NikonPic/full_motor/esc/esc.pdf

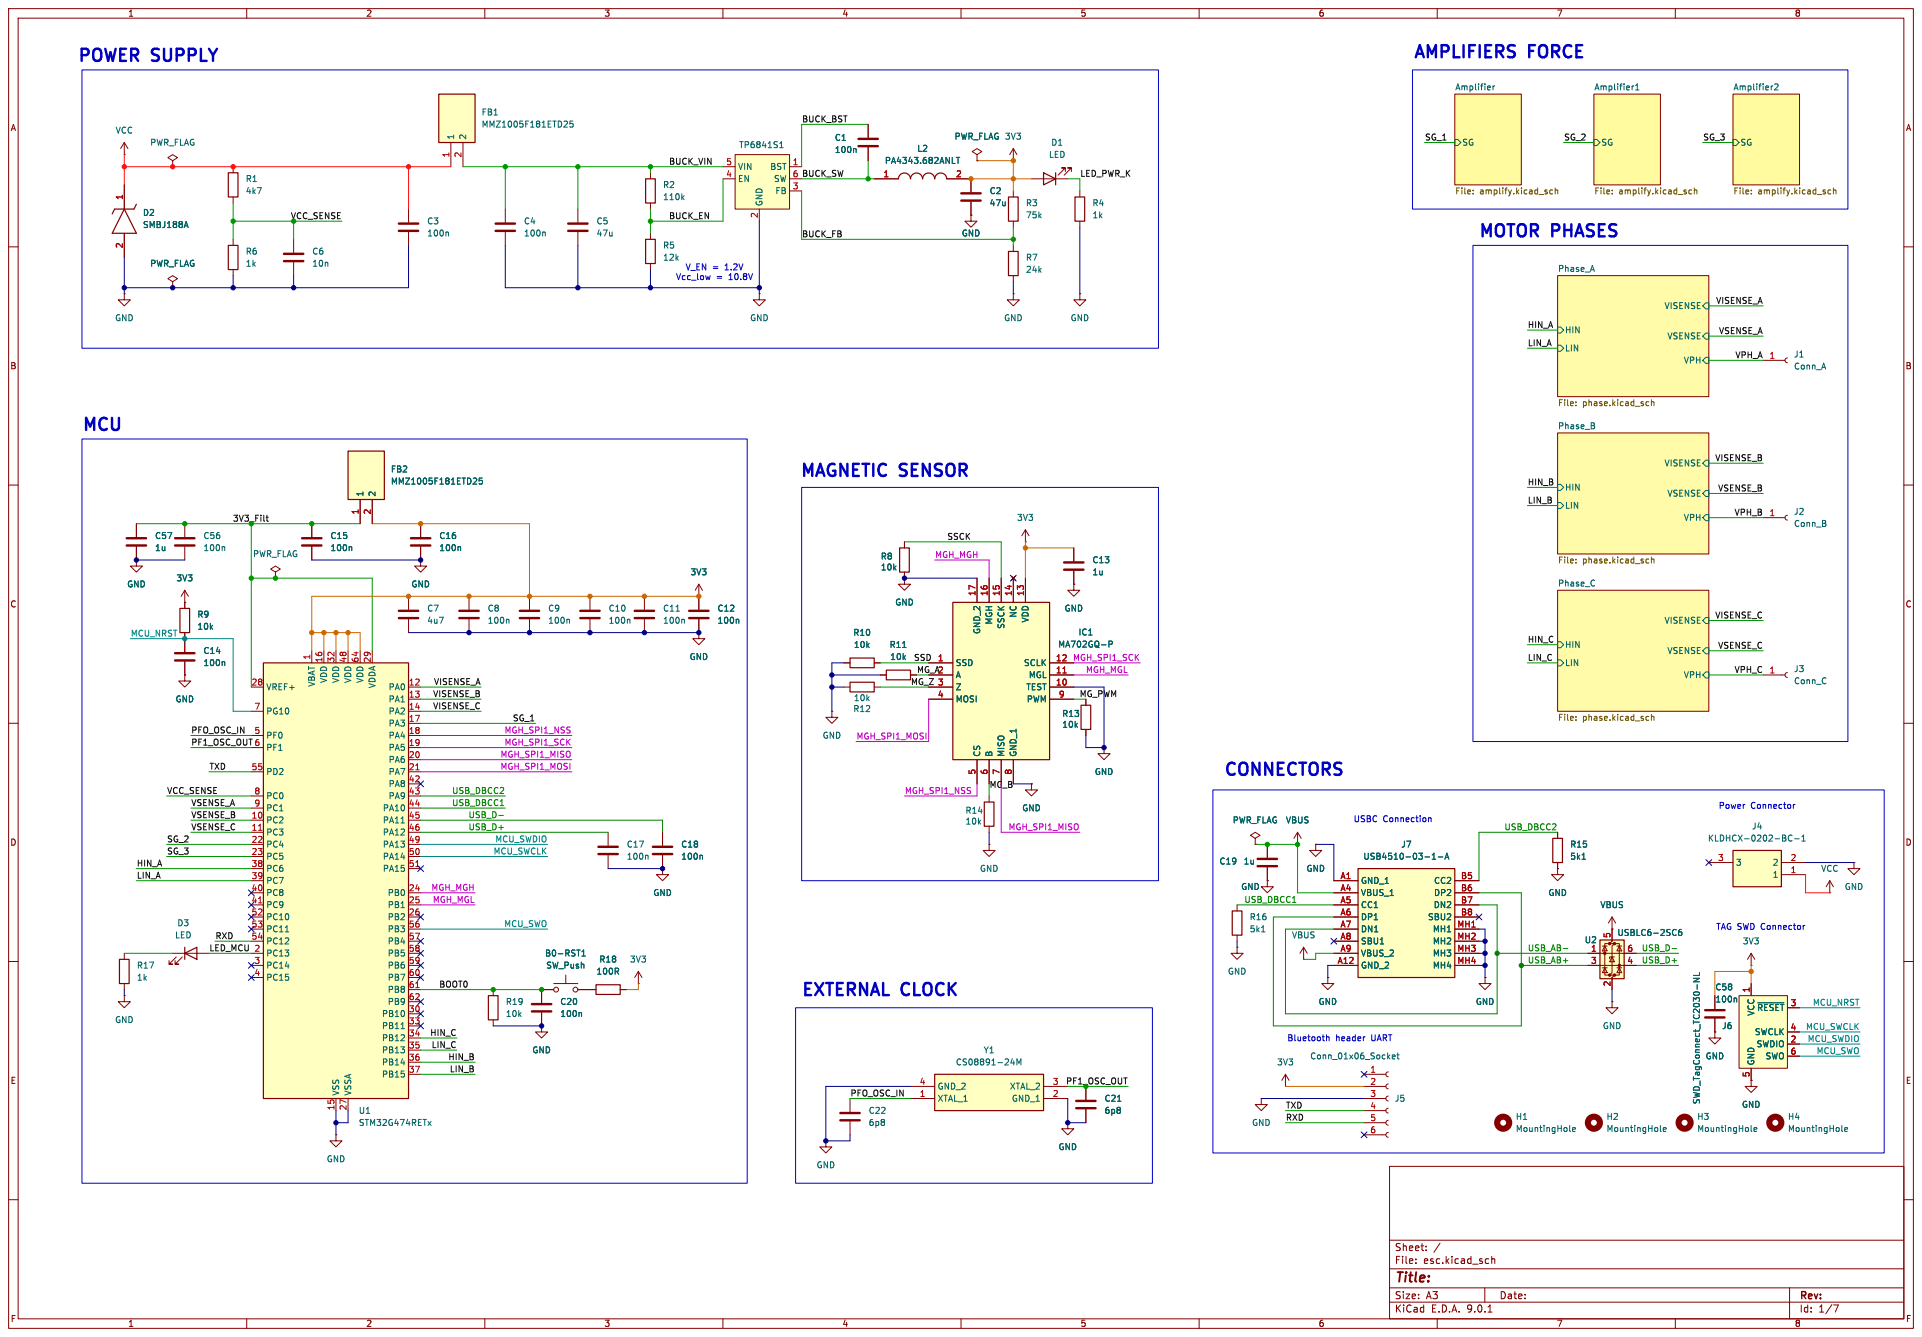
[picture p1: page 1]

8 VDD 13 SCLK 12 MGL 11 TEST 10 PWM 9

8 VDD 13 SCLK 12 MGL 11 TEST 10 PWM 9GND

1 VDD 16 VDD 32 VSS 15 VDD 48 VSSA 27 VDD 64 VDDA 29 PA0 12 PA1 13 PA2 14 PA3 17 PA4 18 PA5 19 PA6 20 PA7 21 PA8 42 PA9 43 PA10 44 PA11 45 PA12 46 PA13 49 PA14 50 PA15 51 PB0 24 PB1 25 PB2 26 PB3 56 PB4 57 PB5 58 PB6 59 PB7 60 PB8 61 PB9 62 PB10 30 PB11 33 PB12 34 PB13 35 PB14 36 PB15 37 U1STM32G474RETx GND

Id: 1/7 Title: File: esc.kicad_sch Sheet: /

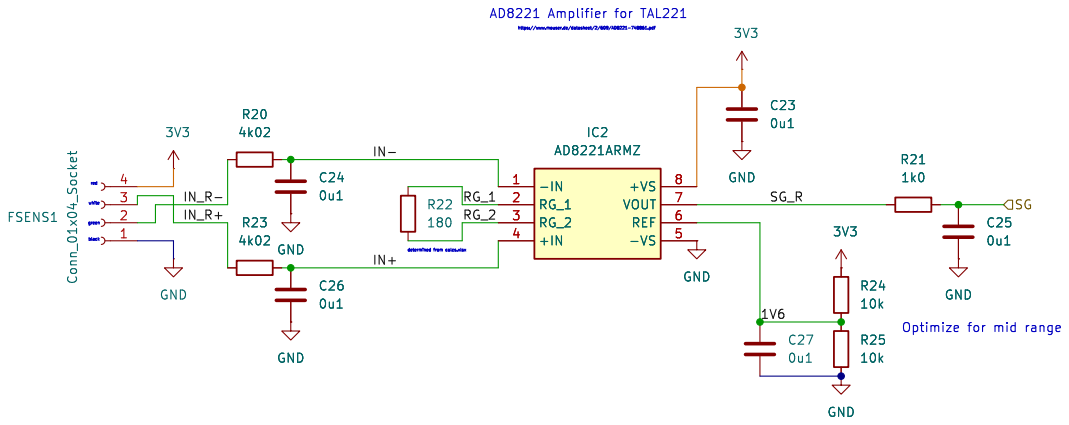
[picture p2: page 2]

Id: 2/7 Title: File: amplify.kicad_sch Sheet: /Amplifier1/ GND

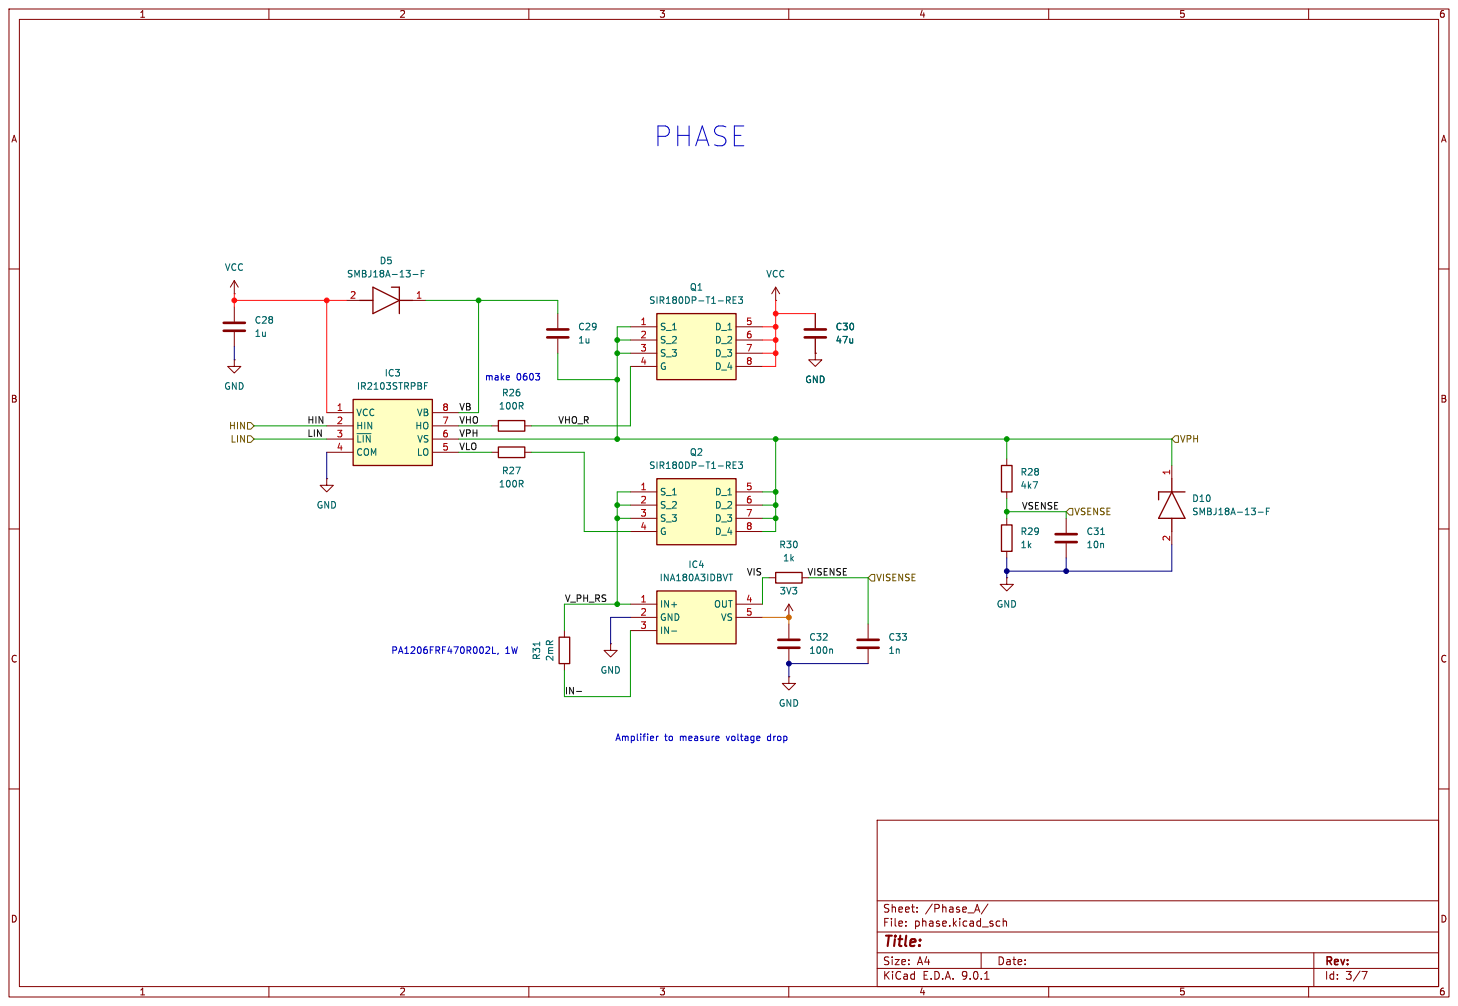
[picture p3: page 3]

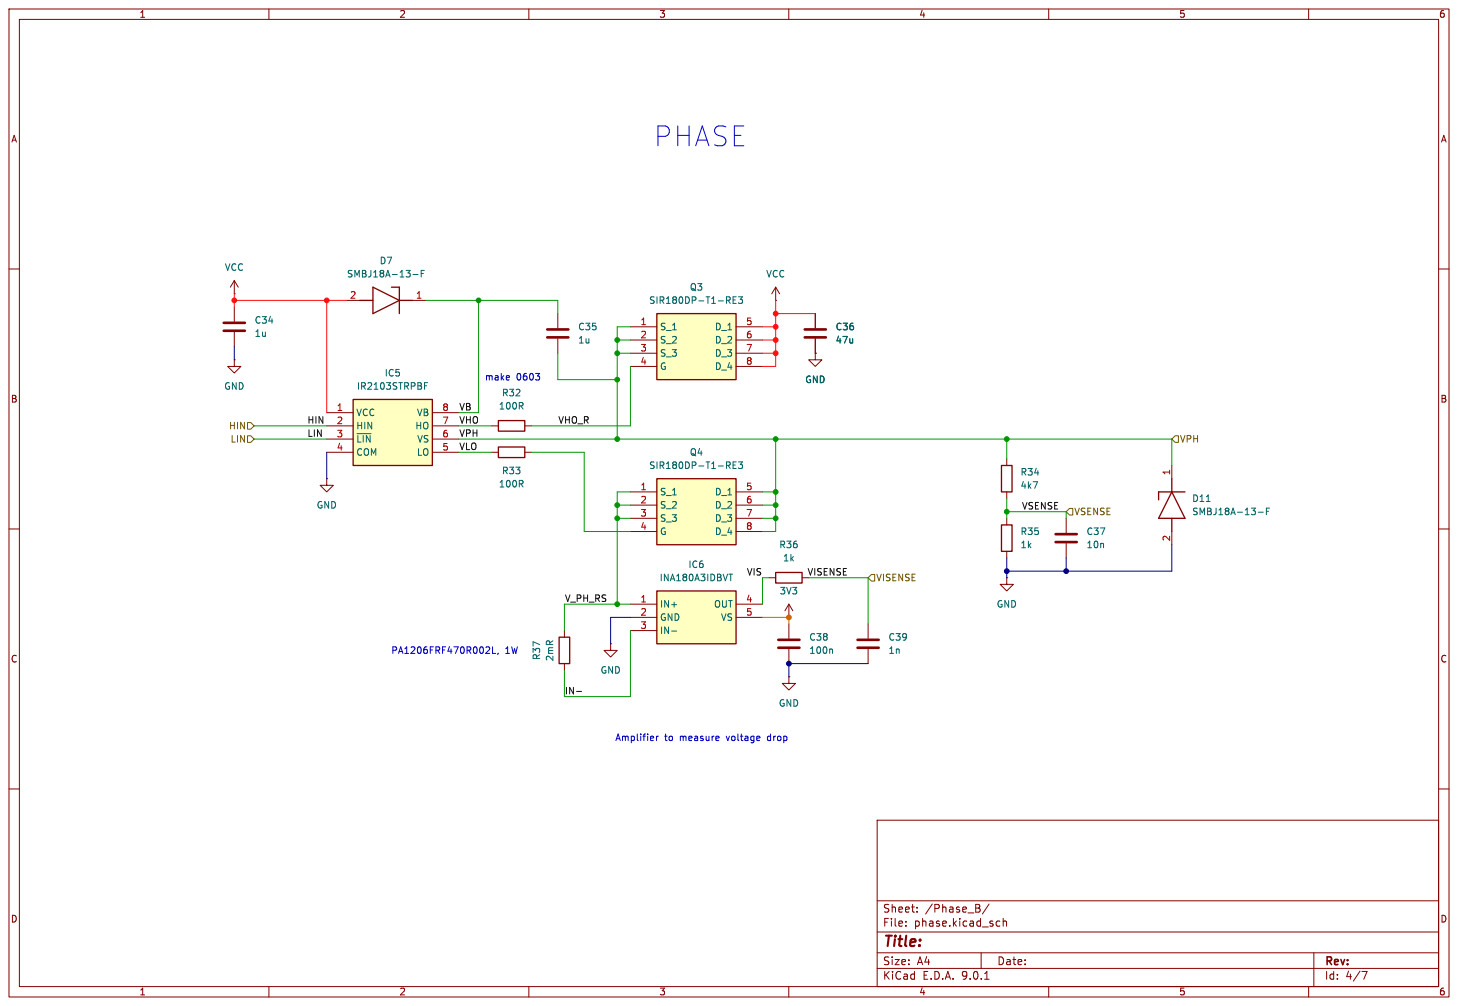
[picture p4: page 4]

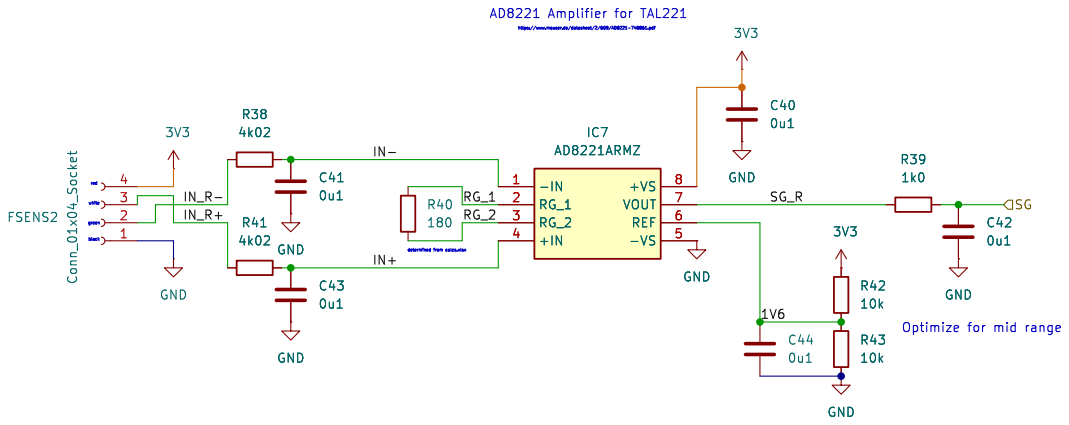
[picture p5: page 5]

Id: 5/7 Title: File: amplify.kicad_sch Sheet: /Amplifier/

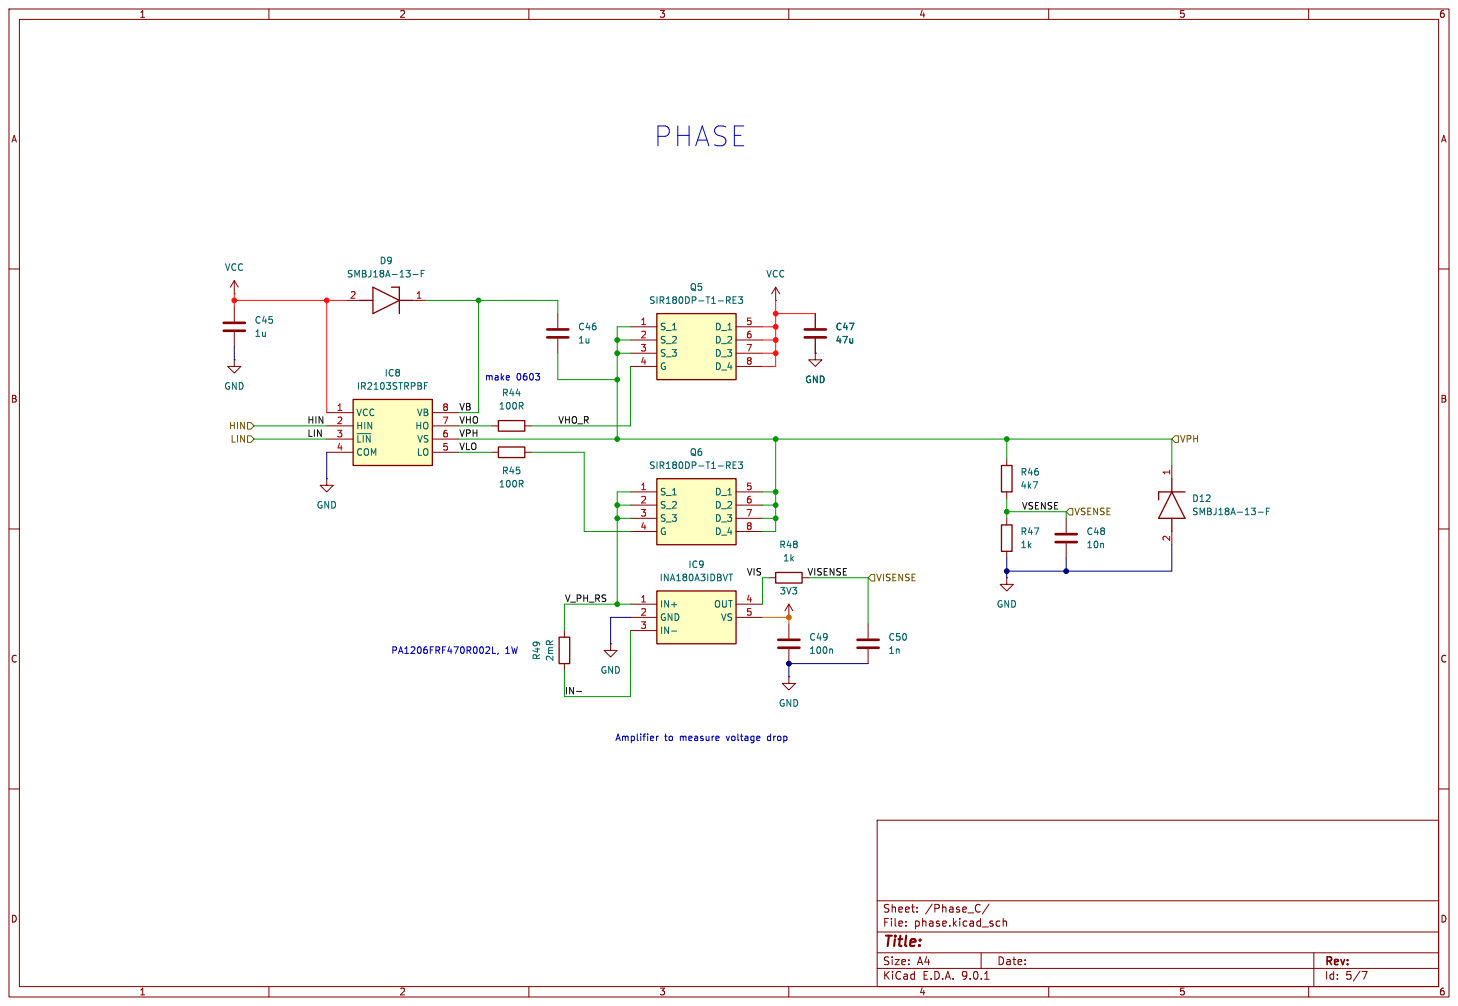
[picture p6: page 6]

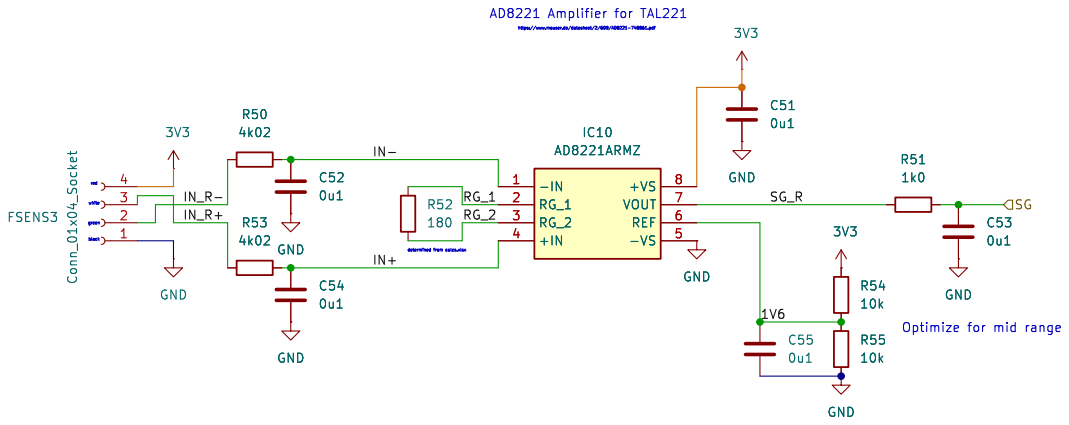
[picture p7: page 7]

Id: 6/7 Title: File: amplify.kicad_sch Sheet: /Amplifier2/ GND
