NikonPic/full_motor/esc/esc.kicad_pcb

## KiCad design esc/esc.kicad_pcb (2025-09-05)

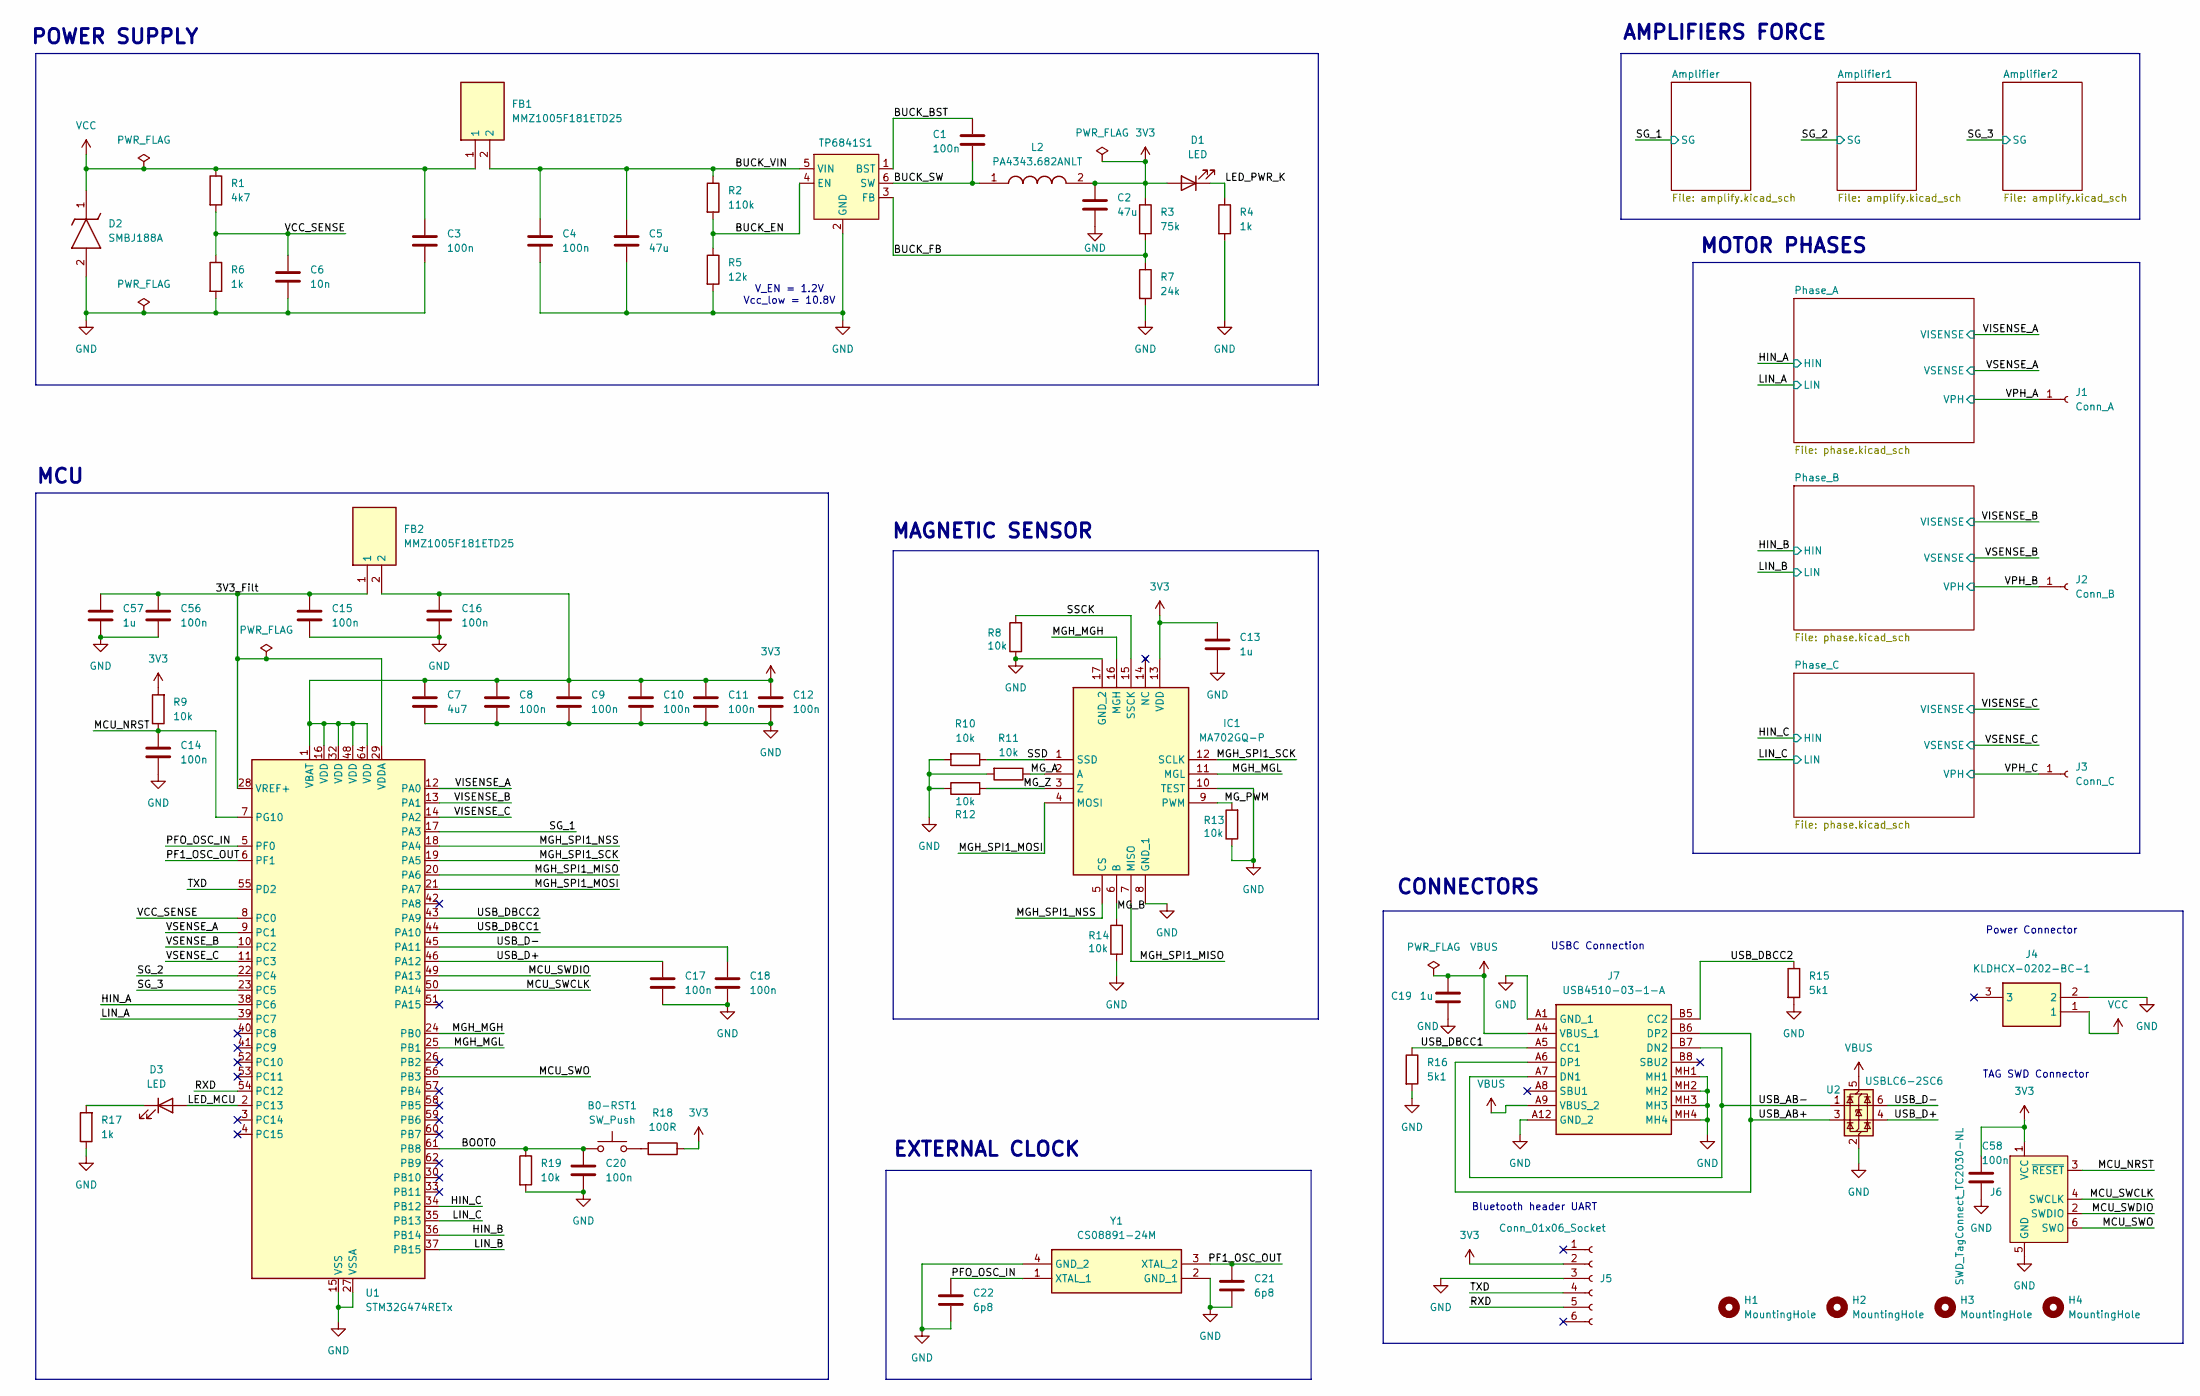
[picture p8: schematic esc.kicad_sch]

Parts:
B0-RST1: SW_Push; SW_SPST_B3U-1000P; MPN 653-B3U-1000P
C1, C3, C4, C8, C9, C10, C11, C12, C14, C15, C16, C17, C18, C20, C56, C58: 100n; C_0402_1005Metric; MPN 81-GRM02YR60G104ME1L
C2, C5: 47u; C_1206_3216Metric; Manufacturer_Part_Number MLASE31LBB5476MTNA01; Mouser Part Number 963-MLASE31LBB5476MT
C6: 10n; C_0402_1005Metric; MPN 77-V0402Y103KXJAC31X
C7: 4u7; C_0603_1608Metric; MPN 963-MLASE168AB5475KT
C13, C19, C57: 1u; C_0603_1608Metric; MPN 963-BJCT168CB7105KR
C21, C22: 6p8; C_0402_1005Metric; MPN 81-GJM0225C1C6R8CB1L
D1, D3: LED; LED_0603_1608Metric; MPN 720-GWJTLMS3.G3G758
D2: SMBJ188A; DIOM5436X244N; Manufacturer_Part_Number SMBJ18A
FB1, FB2: MMZ1005F181ETD25; BEADC1005X55N; Manufacturer_Part_Number MMZ1005F181ETD25; Mouser Part Number 810-MMZ1005F181ETD25
H1, H2, H3, H4: MountingHole; MountingHole_3.2mm_M3
IC1: MA702GQ-P; QFN50P300X300X100-17N-D; Manufacturer_Part_Number MA702GQ-P; Mouser Part Number 946-MA702GQ-P
J1: Conn_A; SolderWire-2sqmm_1x01_D2mm_OD3.9mm
J2: Conn_B; SolderWire-2sqmm_1x01_D2mm_OD3.9mm
J3: Conn_C; SolderWire-2sqmm_1x01_D2mm_OD3.9mm
J4: KLDHCX-0202-BC-1; KLDHCX0202BC1; Manufacturer_Part_Number KLDHCX-0202-BC-1; Mouser Part Number 806-KLDHCX-0202-BC-1
J5: Conn_01x06_Socket; PinSocket_1x06_P2.54mm_Vertical; MPN 437-3158710641003101
J6: SWD_TagConnect_TC2030-NL; Tag-Connect_TC2030-IDC-NL_2x03_P1.27mm_Vertical
J7: USB4510-03-1-A; USB4510031A; Manufacturer_Part_Number USB4510-03-1-A; Mouser Part Number 640-USB4510031A
L2: PA4343.682ANLT; INDPM135126X650N; Manufacturer_Part_Number PA4343.682ANLT; Mouser Part Number 673-PA4343.682ANLT
R1: 4k7; R_0603_1608Metric; MPN 754-RG1608N-472-WT5
R2: 110k; R_0603_1608Metric; MPN 594-MCT06030C1103FP5
R3: 75k; R_0603_1608Metric; MPN 603-RT0603FRE1375KL
R4, R6, R17: 1k; R_0603_1608Metric; MPN 71-CRCW06031K00FKED
R5: 12k; R_0603_1608Metric; MPN 594-MCS04020D1202BE0
R7: 24k; R_0603_1608Metric; MPN 667-ERA-3AEB243V
R8, R9, R10, R11, R12, R13, R14, R19: 10k; R_0603_1608Metric; MPN 708-RNCE0603BTE10K0
R15, R16: 5k1; R_0603_1608Metric; MPN 594-MCT06030C5101FPW
R18: 100R; R_0603_1608Metric; MPN 708-RNCE0603BTE100R
TP6841S1: SOT-23-6
U1: STM32G474RETx; LQFP-64_10x10mm_P0.5mm; MPN 511-STM32G474RET6
U2: USBLC6-2SC6; SOT-23-6; Manufacturer_Part_Number USBLC6-2SC6; Mouser Part Number 511-USBLC6-2SC6
Y1: CS08891-24M; NX2016SA24MEXS00ACS08891; Manufacturer_Part_Number NX2016SA-24M-EXS00A-CS08891; Mouser Part Number 344-NX2016SA24S08891

Connections:
3V3: C2.1, C7.1, C8.1, C9.1, C10.1, C11.1, C12.1, C13.1, C16.1, C58.1, D1.2 (A), FB2.2, IC1.13 (VDD), J5.2, J6.1 (VCC), L2.2, R3.1, R9.2, R18.1, U1.1 (VBAT), U1.16 (VDD), U1.32 (VDD), U1.48 (VDD), U1.64 (VDD); also elsewhere on the board
/3V3_Filt: C15.1, C56.1, C57.1, FB2.1, U1.28 (VREF+), U1.29 (VDDA)
/BOOT0: B0-RST1.1, C20.1, R19.1, U1.61 (PB8)
/BUCK_BST: C1.1, TP6841S1.1 (BST)
/BUCK_EN: R2.2, R5.1, TP6841S1.4 (EN)
/BUCK_FB: R3.2, R7.1, TP6841S1.3 (FB)
/BUCK_SW: C1.2, L2.1, TP6841S1.6 (SW)
/BUCK_VIN: C4.1, C5.1, FB1.2, R2.1, TP6841S1.5 (VIN)
/HIN_A: U1.38 (PC6); also elsewhere on the board
/HIN_B: U1.36 (PB14); also elsewhere on the board
/HIN_C: U1.34 (PB12); also elsewhere on the board
/LED_MCU: D3.2 (A), U1.2 (PC13)
/LED_PWR_K: D1.1 (K), R4.1
/LIN_A: U1.39 (PC7); also elsewhere on the board
/LIN_B: U1.37 (PB15); also elsewhere on the board
/LIN_C: U1.35 (PB13); also elsewhere on the board
/MCU_NRST: C14.1, J6.3 (~RESET), R9.1, U1.7 (PG10)
/MCU_SWCLK: J6.4 (SWCLK), U1.50 (PA14)
/MCU_SWDIO: J6.2 (SWDIO), U1.49 (PA13)
/MCU_SWO: J6.6 (SWO), U1.56 (PB3)
/MGH_MGH: IC1.16 (MGH), U1.24 (PB0)
/MGH_MGL: IC1.11 (MGL), U1.25 (PB1)
/MGH_SPI1_MISO: IC1.7 (MISO), U1.20 (PA6)
/MGH_SPI1_MOSI: IC1.4 (MOSI), U1.21 (PA7)
/MGH_SPI1_NSS: IC1.5 (CS), U1.18 (PA4)
/MGH_SPI1_SCK: IC1.12 (SCLK), U1.19 (PA5)
/MG_A: IC1.2 (A), R11.1
/MG_B: IC1.6 (B), R14.2
/MG_PWM: IC1.9 (PWM), R13.2
/MG_Z: IC1.3 (Z), R12.2
/PF1_OSC_OUT: C21.1, U1.6 (PF1), Y1.3 (XTAL_2)
/PFO_OSC_IN: C22.1, U1.5 (PF0), Y1.1 (XTAL_1)
/RXD: J5.5, U1.54 (PC12)
/SG_1: U1.17 (PA3); also elsewhere on the board
/SG_2: U1.22 (PC4); also elsewhere on the board
/SG_3: U1.23 (PC5); also elsewhere on the board
/SSCK: IC1.15 (SSCK), R8.2
/SSD: IC1.1 (SSD), R10.1
/TXD: J5.4, U1.55 (PD2)
/USB_AB+: J7.A6 (DP1), J7.B6 (DP2), U2.3 (I/O2)
/USB_AB-: J7.A7 (DN1), J7.B7 (DN2), U2.1 (I/O1)
/USB_D+: C17.1, U1.46 (PA12), U2.4 (I/O2)
/USB_D-: C18.1, U1.45 (PA11), U2.6 (I/O1)
/USB_DBCC1: J7.A5 (CC1), R16.1, U1.44 (PA10)
/USB_DBCC2: J7.B5 (CC2), R15.1, U1.43 (PA9)
/VCC_SENSE: C6.1, R1.2, R6.1, U1.8 (PC0)
/VISENSE_A: U1.12 (PA0); also elsewhere on the board
/VISENSE_B: U1.13 (PA1); also elsewhere on the board
/VISENSE_C: U1.14 (PA2); also elsewhere on the board
/VPH_A: J1.1; also elsewhere on the board
/VPH_B: J2.1; also elsewhere on the board
/VPH_C: J3.1; also elsewhere on the board
/VSENSE_A: U1.9 (PC1); also elsewhere on the board
/VSENSE_B: U1.10 (PC2); also elsewhere on the board
/VSENSE_C: U1.11 (PC3); also elsewhere on the board
GND: C2.2, C3.2, C4.2, C5.2, C6.2, C7.2, C8.2, C9.2, C10.2, C11.2, C12.2, C13.2, C14.2, C15.2, C16.2, C17.2, C18.2, C19.2, C20.2, C21.2, C22.2, C56.2, C57.2, C58.2, D2.2 (A), IC1.8 (GND_1), IC1.10 (TEST), IC1.17 (GND_2), J4.2, J5.3, J6.5 (GND), J7.A1 (GND_1), J7.A12 (GND_2), J7.MH1, J7.MH2, J7.MH3, J7.MH4, R4.2, R5.2, R6.2, R7.2, R8.1, R10.2, R11.2, R12.1, R13.1, R14.1, R15.2, R16.2, R17.1, R19.2, TP6841S1.2 (GND), U1.15 (VSS), U1.27 (VSSA), U1.31 (VSS), U1.47 (VSS), U1.63 (VSS), U2.2 (GND), Y1.2 (GND_1), Y1.4 (GND_2); also elsewhere on the board
unnamed: B0-RST1.2, R18.2
unnamed: D3.1 (K), R17.2
VBUS: C19.1, J7.A4 (VBUS_1), J7.A9 (VBUS_2), U2.5 (VBUS)
VCC: C3.1, D2.1 (K), FB1.1, J4.1, R1.1; also elsewhere on the board

Notes on the sheet:
MOTOR PHASES
POWER SUPPLY
CONNECTORS
MCU
TAG SWD Connector
Power Connector
AMPLIFIERS FORCE
USBC Connection
MAGNETIC SENSOR
V_EN = 1.2V Vcc_low = 10.8V
EXTERNAL CLOCK
Bluetooth header UART

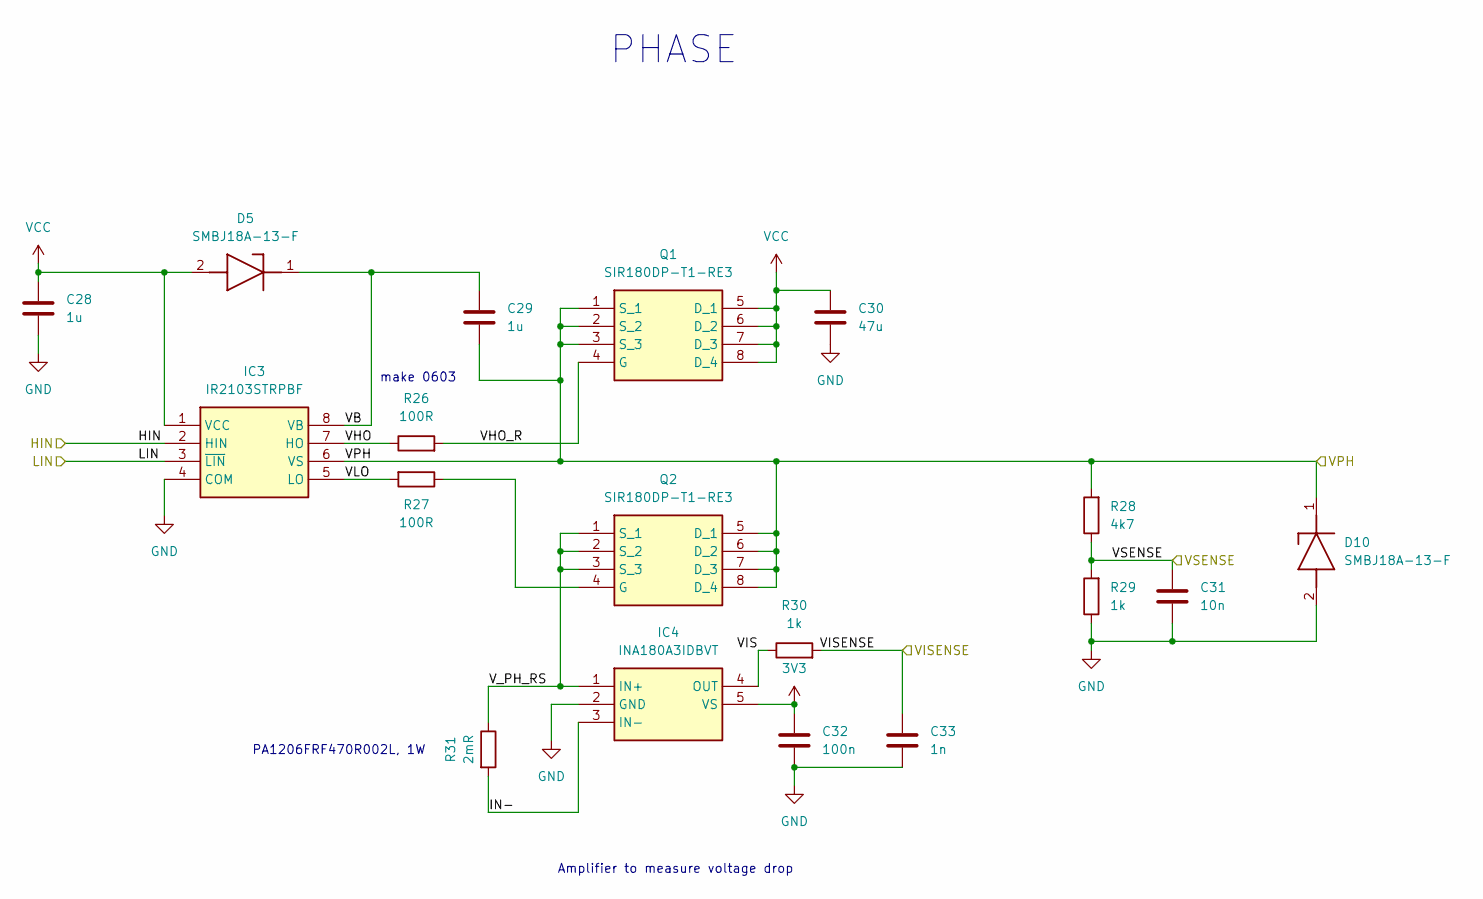
[picture p9: schematic phase.kicad_sch]

Parts:
C28, C29: 1u; C_0603_1608Metric; MPN 963-BJCT168CB7105KR
C30: 47u; C_1206_3216Metric; Manufacturer_Part_Number MLASE31LBB5476MTNA01; Mouser Part Number 963-MLASE31LBB5476MT
C31: 10n; C_0402_1005Metric; MPN 77-V0402Y103KXJAC31X
C32: 100n; C_0402_1005Metric; MPN 81-GRM02YR60G104ME1L
C33: 1n; C_0402_1005Metric; MPN 963-MLASE042SB5102MW
D5, D10: SMBJ18A-13-F; DIOM5336X250N; Manufacturer_Part_Number SMBJ18A-13-F; Mouser Part Number 621-SMBJ18A-13-F
IC3: IR2103STRPBF; SOIC127P600X175-8N; Manufacturer_Part_Number IR2103STRPBF; Mouser Part Number 942-IR2103STRPBF
IC4: INA180A3IDBVT; SOT95P280X145-5N; Manufacturer_Part_Number INA180A3IDBVT; Mouser Part Number 595-INA180A3IDBVT
Q1, Q2: SIR180DP-T1-RE3; SI7141DPT1GE3; Manufacturer_Part_Number SiR180DP-T1-RE3; Mouser Part Number 78-SIR180DP-T1-RE3
R26, R27: 100R; R_0603_1608Metric; MPN 708-RNCE0603BTE100R
R28: 4k7; R_0603_1608Metric; MPN 754-RG1608N-472-WT5
R29, R30: 1k; R_0603_1608Metric; MPN 71-CRCW06031K00FKED
R31: 2mR; R_1206_3216Metric; MPN 603-P1206FRF470R002L

Connections:
3V3: C32.1, IC4.5 (VS); also elsewhere on the board
/HIN_A: IC3.2 (HIN); also elsewhere on the board
/LIN_A: IC3.3 (~LIN); also elsewhere on the board
/Phase_A/IN-: IC4.3 (IN-), R31.2
/Phase_A/VB: C29.1, D5.1 (K), IC3.8 (VB)
/Phase_A/VHO: IC3.7 (HO), R26.1
/Phase_A/VHO_R: Q1.4 (G), R26.2
/Phase_A/VIS: IC4.4 (OUT), R30.1
/Phase_A/VLO: IC3.5 (LO), R27.2
/Phase_A/V_PH_RS: IC4.1 (IN+), Q2.1 (S_1), Q2.2 (S_2), Q2.3 (S_3), R31.1
/VISENSE_A: C33.1, R30.2; also elsewhere on the board
/VPH_A: C29.2, D10.1 (K), IC3.6 (VS), Q1.1 (S_1), Q1.2 (S_2), Q1.3 (S_3), Q2.5 (D_1), Q2.6 (D_2), Q2.7 (D_3), Q2.8 (D_4), R28.2; also elsewhere on the board
/VSENSE_A: C31.1, R28.1, R29.2; also elsewhere on the board
GND: C28.2, C30.2, C31.2, C32.2, C33.2, D10.2 (A), IC3.4 (COM), IC4.2 (GND), R29.1; also elsewhere on the board
unnamed: Q2.4 (G), R27.1
VCC: C28.1, C30.1, D5.2 (A), IC3.1 (VCC), Q1.5 (D_1), Q1.6 (D_2), Q1.7 (D_3), Q1.8 (D_4); also elsewhere on the board

Parts of its further copies:
C34, C35, C45, C46: 1u; C_0603_1608Metric; MPN 963-BJCT168CB7105KR
C36, C47: 47u; C_1206_3216Metric; Manufacturer_Part_Number MLASE31LBB5476MTNA01; Mouser Part Number 963-MLASE31LBB5476MT
C37, C48: 10n; C_0402_1005Metric; MPN 77-V0402Y103KXJAC31X
C38, C49: 100n; C_0402_1005Metric; MPN 81-GRM02YR60G104ME1L
C39, C50: 1n; C_0402_1005Metric; MPN 963-MLASE042SB5102MW
D7, D9, D11, D12: SMBJ18A-13-F; DIOM5336X250N; Manufacturer_Part_Number SMBJ18A-13-F; Mouser Part Number 621-SMBJ18A-13-F
IC5, IC8: IR2103STRPBF; SOIC127P600X175-8N; Manufacturer_Part_Number IR2103STRPBF; Mouser Part Number 942-IR2103STRPBF
IC6, IC9: INA180A3IDBVT; SOT95P280X145-5N; Manufacturer_Part_Number INA180A3IDBVT; Mouser Part Number 595-INA180A3IDBVT
Q3, Q4, Q5, Q6: SIR180DP-T1-RE3; SI7141DPT1GE3; Manufacturer_Part_Number SiR180DP-T1-RE3; Mouser Part Number 78-SIR180DP-T1-RE3
R32, R33, R44, R45: 100R; R_0603_1608Metric; MPN 708-RNCE0603BTE100R
R34, R46: 4k7; R_0603_1608Metric; MPN 754-RG1608N-472-WT5
R35, R36, R47, R48: 1k; R_0603_1608Metric; MPN 71-CRCW06031K00FKED
R37, R49: 2mR; R_1206_3216Metric; MPN 603-P1206FRF470R002L

Connections of its further copies:
3V3: C38.1, C49.1, IC6.5 (VS), IC9.5 (VS); also elsewhere on the board
/HIN_B: IC5.2 (HIN); also elsewhere on the board
/HIN_C: IC8.2 (HIN); also elsewhere on the board
/LIN_B: IC5.3 (~LIN); also elsewhere on the board
/LIN_C: IC8.3 (~LIN); also elsewhere on the board
/Phase_B/IN-: IC6.3 (IN-), R37.2
/Phase_B/VB: C35.1, D7.1 (K), IC5.8 (VB)
/Phase_B/VHO: IC5.7 (HO), R32.1
/Phase_B/VHO_R: Q3.4 (G), R32.2
/Phase_B/VIS: IC6.4 (OUT), R36.1
/Phase_B/VLO: IC5.5 (LO), R33.2
/Phase_B/V_PH_RS: IC6.1 (IN+), Q4.1 (S_1), Q4.2 (S_2), Q4.3 (S_3), R37.1
/Phase_C/IN-: IC9.3 (IN-), R49.2
/Phase_C/VB: C46.1, D9.1 (K), IC8.8 (VB)
/Phase_C/VHO: IC8.7 (HO), R44.1
/Phase_C/VHO_R: Q5.4 (G), R44.2
/Phase_C/VIS: IC9.4 (OUT), R48.1
/Phase_C/VLO: IC8.5 (LO), R45.2
/Phase_C/V_PH_RS: IC9.1 (IN+), Q6.1 (S_1), Q6.2 (S_2), Q6.3 (S_3), R49.1
/VISENSE_B: C39.1, R36.2; also elsewhere on the board
/VISENSE_C: C50.1, R48.2; also elsewhere on the board
/VPH_B: C35.2, D11.1 (K), IC5.6 (VS), Q3.1 (S_1), Q3.2 (S_2), Q3.3 (S_3), Q4.5 (D_1), Q4.6 (D_2), Q4.7 (D_3), Q4.8 (D_4), R34.2; also elsewhere on the board
/VPH_C: C46.2, D12.1 (K), IC8.6 (VS), Q5.1 (S_1), Q5.2 (S_2), Q5.3 (S_3), Q6.5 (D_1), Q6.6 (D_2), Q6.7 (D_3), Q6.8 (D_4), R46.2; also elsewhere on the board
/VSENSE_B: C37.1, R34.1, R35.2; also elsewhere on the board
/VSENSE_C: C48.1, R46.1, R47.2; also elsewhere on the board
GND: C34.2, C36.2, C37.2, C38.2, C39.2, C45.2, C47.2, C48.2, C49.2, C50.2, D11.2 (A), D12.2 (A), IC5.4 (COM), IC6.2 (GND), IC8.4 (COM), IC9.2 (GND), R35.1, R47.1; also elsewhere on the board
unnamed: Q4.4 (G), R33.1
unnamed: Q6.4 (G), R45.1
VCC: C34.1, C36.1, C45.1, C47.1, D7.2 (A), D9.2 (A), IC5.1 (VCC), IC8.1 (VCC), Q3.5 (D_1), Q3.6 (D_2), Q3.7 (D_3), Q3.8 (D_4), Q5.5 (D_1), Q5.6 (D_2), Q5.7 (D_3), Q5.8 (D_4); also elsewhere on the board

Notes on the sheet:
PA1206FRF470R002L, 1W
PHASE
make 0603
Amplifier to measure voltage drop

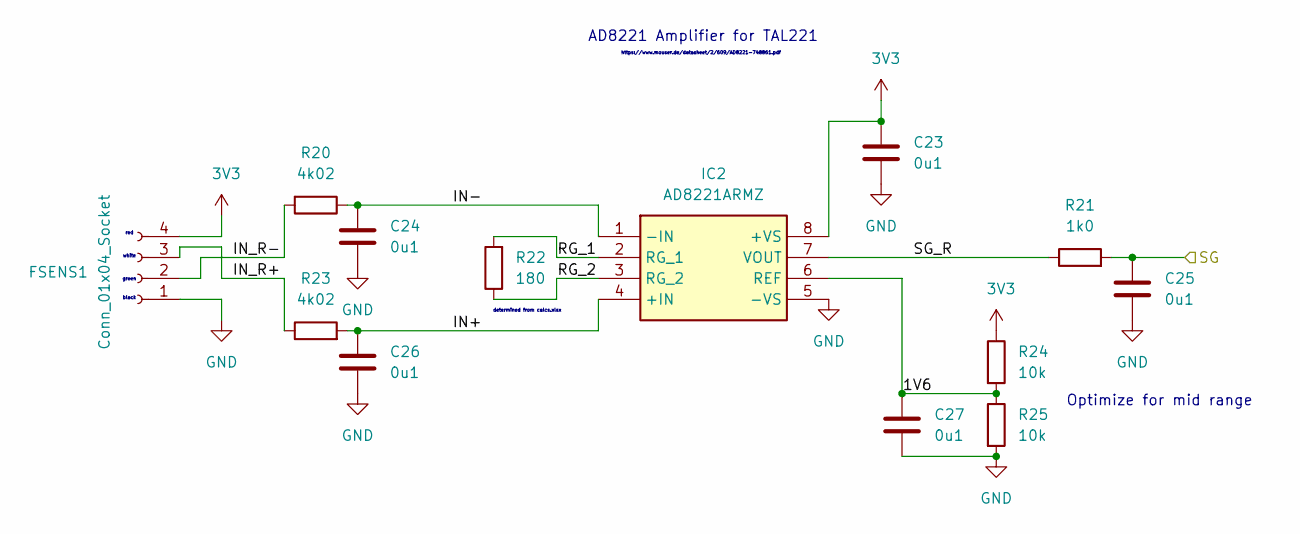
[picture p10: schematic amplify.kicad_sch]

Parts:
C23, C24, C25, C26, C27: 0u1; C_0603_1608Metric; MPN 187-CL10B104KB8NFNC
FSENS1: Conn_01x04_Socket; JST_XH_S4B-XH-A-1_1x04_P2.50mm_Horizontal; MPN 306-S4B-XH-ALFSN
IC2: AD8221ARMZ; SOP65P490X110-8N; Manufacturer_Part_Number AD8221ARMZ; Mouser Part Number 584-AD8221ARMZ
R20, R23: 4k02; R_0603_1608Metric; MPN 754-RR0816P-4021D59H
R21: 1k0; R_0603_1608Metric; MPN 71-CRCW06031K00FKED
R22: 180; R_0603_1608Metric; MPN 603-RT0603FRD07180RL
R24, R25: 10k; R_0603_1608Metric; MPN 708-RNCE0603BTE10K0

Connections:
3V3: C23.1, FSENS1.4, IC2.8 (+VS), R24.1; also elsewhere on the board
/Amplifier1/1V6: C27.1, IC2.6 (REF), R24.2, R25.1
/Amplifier1/IN+: C26.1, IC2.4 (+IN), R23.2
/Amplifier1/IN-: C24.1, IC2.1 (-IN), R20.1
/Amplifier1/IN_R+: FSENS1.3, R23.1
/Amplifier1/IN_R-: FSENS1.2, R20.2
/Amplifier1/RG_1: IC2.2 (RG_1), R22.2
/Amplifier1/RG_2: IC2.3 (RG_2), R22.1
/Amplifier1/SG_R: IC2.7 (VOUT), R21.1
/SG_2: C25.1, R21.2; also elsewhere on the board
GND: C23.2, C24.2, C25.2, C26.2, C27.2, FSENS1.1, IC2.5 (-VS), R25.2; also elsewhere on the board

Parts of its further copies:
C40, C41, C42, C43, C44, C51, C52, C53, C54, C55: 0u1; C_0603_1608Metric; MPN 187-CL10B104KB8NFNC
FSENS2, FSENS3: Conn_01x04_Socket; JST_XH_S4B-XH-A-1_1x04_P2.50mm_Horizontal; MPN 306-S4B-XH-ALFSN
IC7, IC10: AD8221ARMZ; SOP65P490X110-8N; Manufacturer_Part_Number AD8221ARMZ; Mouser Part Number 584-AD8221ARMZ
R38, R41, R50, R53: 4k02; R_0603_1608Metric; MPN 754-RR0816P-4021D59H
R39, R51: 1k0; R_0603_1608Metric; MPN 71-CRCW06031K00FKED
R40, R52: 180; R_0603_1608Metric; MPN 603-RT0603FRD07180RL
R42, R43, R54, R55: 10k; R_0603_1608Metric; MPN 708-RNCE0603BTE10K0

Connections of its further copies:
3V3: C40.1, C51.1, FSENS2.4, FSENS3.4, IC7.8 (+VS), IC10.8 (+VS), R42.1, R54.1; also elsewhere on the board
/Amplifier2/1V6: C55.1, IC10.6 (REF), R54.2, R55.1
/Amplifier2/IN+: C54.1, IC10.4 (+IN), R53.2
/Amplifier2/IN-: C52.1, IC10.1 (-IN), R50.1
/Amplifier2/IN_R+: FSENS3.3, R53.1
/Amplifier2/IN_R-: FSENS3.2, R50.2
/Amplifier2/RG_1: IC10.2 (RG_1), R52.2
/Amplifier2/RG_2: IC10.3 (RG_2), R52.1
/Amplifier2/SG_R: IC10.7 (VOUT), R51.1
/Amplifier/1V6: C44.1, IC7.6 (REF), R42.2, R43.1
/Amplifier/IN+: C43.1, IC7.4 (+IN), R41.2
/Amplifier/IN-: C41.1, IC7.1 (-IN), R38.1
/Amplifier/IN_R+: FSENS2.3, R41.1
/Amplifier/IN_R-: FSENS2.2, R38.2
/Amplifier/RG_1: IC7.2 (RG_1), R40.2
/Amplifier/RG_2: IC7.3 (RG_2), R40.1
/Amplifier/SG_R: IC7.7 (VOUT), R39.1
/SG_1: C42.1, R39.2; also elsewhere on the board
/SG_3: C53.1, R51.2; also elsewhere on the board
GND: C40.2, C41.2, C42.2, C43.2, C44.2, C51.2, C52.2, C53.2, C54.2, C55.2, FSENS2.1, FSENS3.1, IC7.5 (-VS), IC10.5 (-VS), R43.2, R55.2; also elsewhere on the board

Notes on the sheet:
Optimize for mid range
https://www.mouser.de/datasheet/2/609/AD8221-748861.pdf
red
green
white
AD8221 Amplifier for TAL221
black
determined from calcs.xlsx

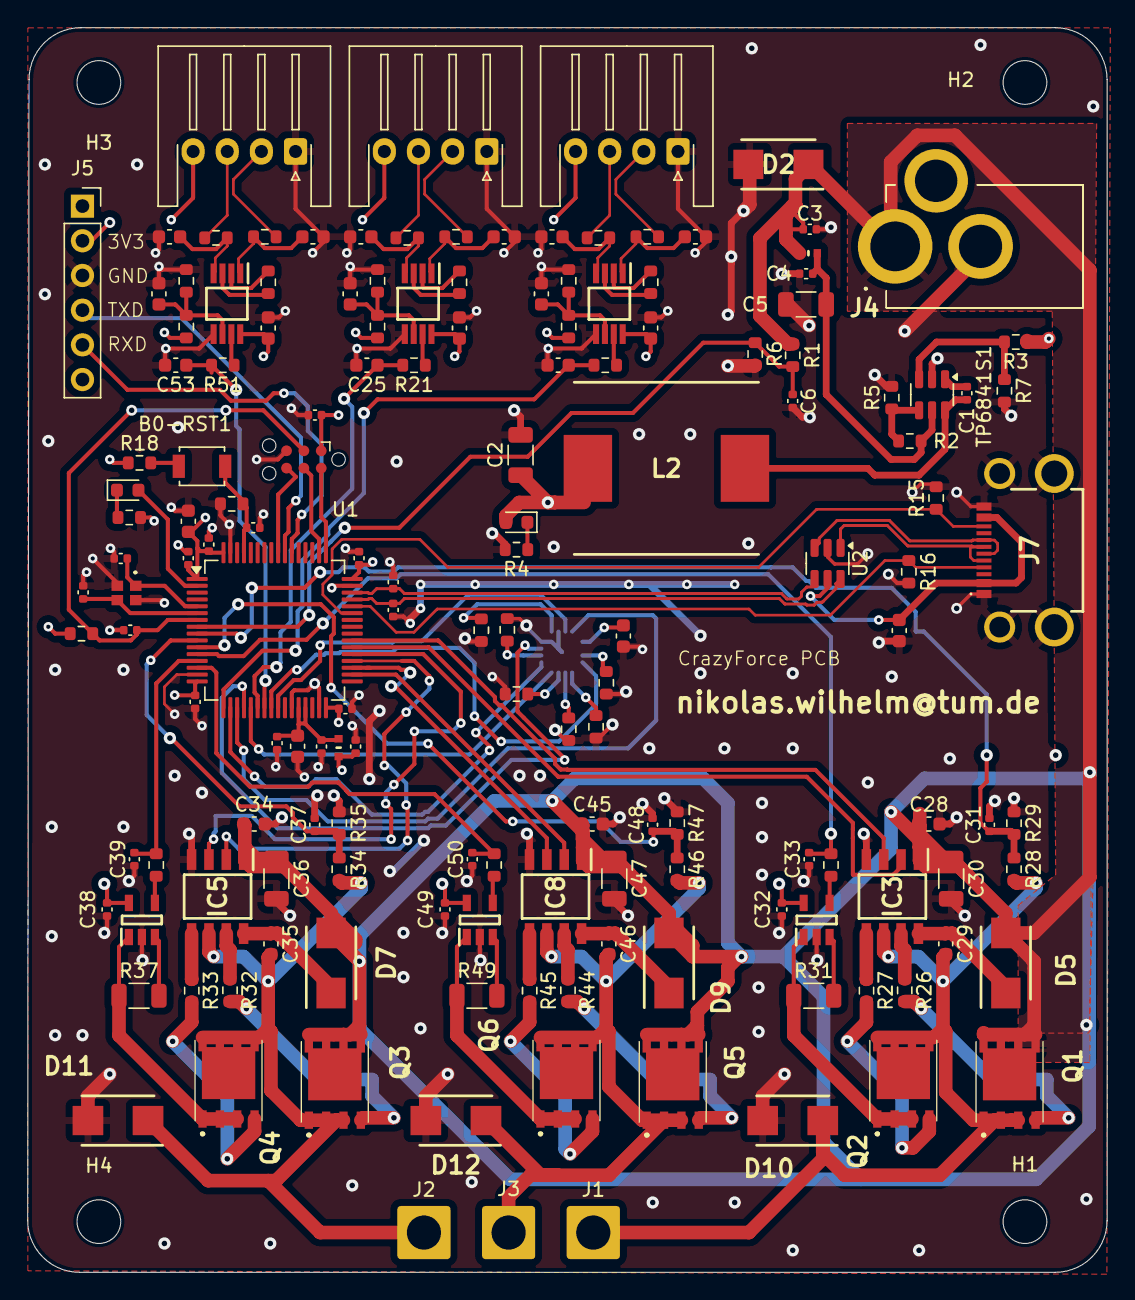
[picture p11: board esc.kicad_pcb from above]

Board: 4 copper layers, 79.0 x 91.1 mm, 160 parts (1 on the bottom side), 108 nets.
