NikonPic/full_motor/fullmotor/fullmotor.ioc

Mcu.UserName=STM32G474RETx
PA0.Signal=ADC1_IN1
PA1.Signal=ADC2_IN2
PA10.Signal=UCPD1_DBCC2
PA11.Signal=USB_DM
PA12.Signal=USB_DP
PA13.Signal=SYS_JTMS-SWDIO
PA14.Signal=SYS_JTCK-SWCLK
PA2.Signal=ADC1_IN3
PA3.Signal=ADC1_IN4
PA4.Signal=SPI1_NSS
PA5.Signal=SPI1_SCK
PA6.Signal=SPI1_MISO
PA7.Signal=SPI1_MOSI
PA9.Signal=UCPD1_DBCC1
PB0.Signal=GPIO_Input
PB1.Signal=GPIO_Input
PB12.Signal=HRTIM1_CHC1
PB13.Signal=HRTIM1_CHC2
PB14.Signal=HRTIM1_CHD1
PB15.Signal=HRTIM1_CHD2
PB3.Signal=SYS_JTDO-SWO
PC0.Signal=ADC1_IN6
PC1.Signal=ADC2_IN7
PC12.Signal=UART5_TX
PC2.Signal=ADC1_IN8
PC3.Signal=ADC2_IN9
PC4.Signal=ADC2_IN5
PC5.Signal=ADC2_IN11
PC6.Signal=HRTIM1_CHF1
PC7.Signal=HRTIM1_CHF2
PD2.Signal=UART5_RX
