NikonPic/full_motor/(commit log)

2025-04-29 init commit esc design
    [esc.kicad_pcb, esc.kicad_sch, power.kicad_sch]
2025-05-05 with phase
    [esc.kicad_pcb, esc.kicad_sch, phase.kicad_sch, power.kicad_sch]
2025-05-13 esc changes
    [esc.kicad_sch, phase.kicad_sch]
2025-05-30 full layout
    [amplify.kicad_sch, esc.kicad_pcb, esc.kicad_sch, phase.kicad_sch]
2025-06-02 ready for production..?
    [esc.csv, esc.kicad_pcb, esc.kicad_sch, phase.kicad_sch]
2025-09-02 adding esc kicad and stm32cubeide project
    [amplify.kicad_sch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]
2025-09-05 with the used libraries
    [esc.kicad_pcb, esc.kicad_sch]
